rym88/PSA-Can2004-AEE2004-Cluster-for-simracing-via-Simhub---Peugeot-407-Simracing-cluster-prototype/WhatsApp Image 2026-07-12 at 19.18.00 (1).jpeg

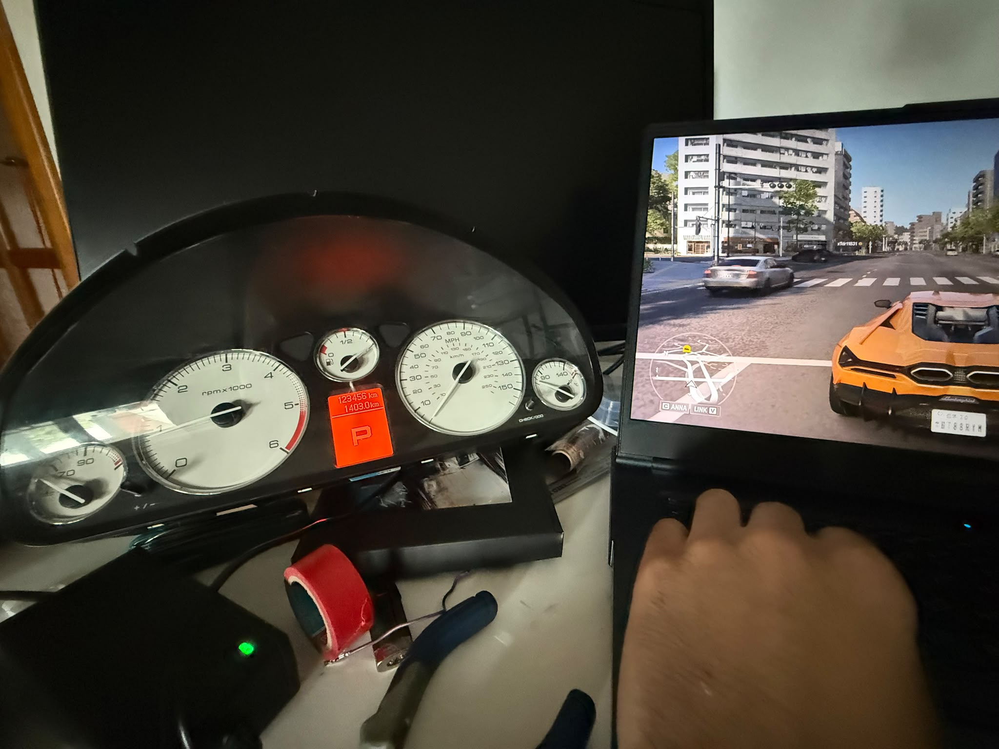
WhatsApp Image 2026-07-12 at 19.18.00 (1).jpeg
